hooberman/prototype/Documentation/BoardConfig.pptx

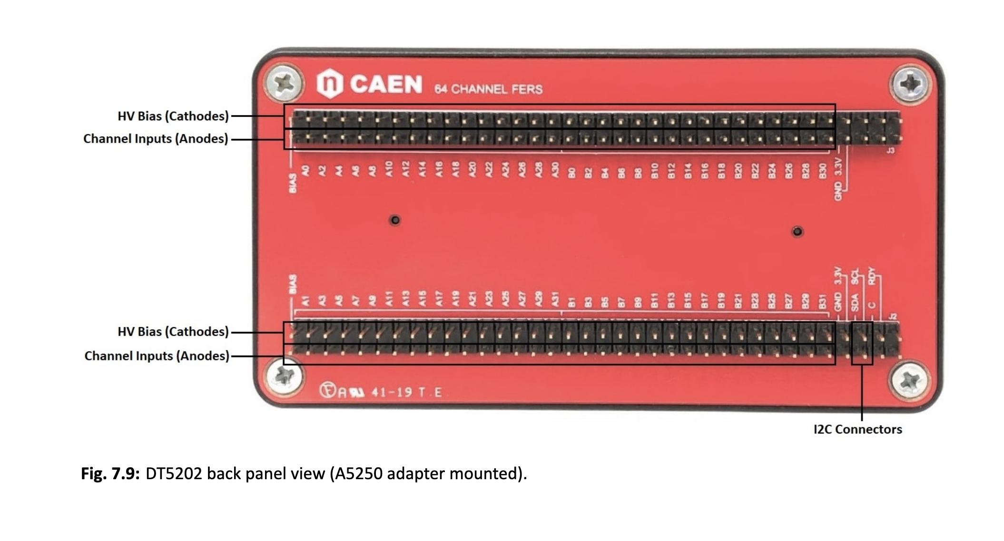
[picture p1: figure]
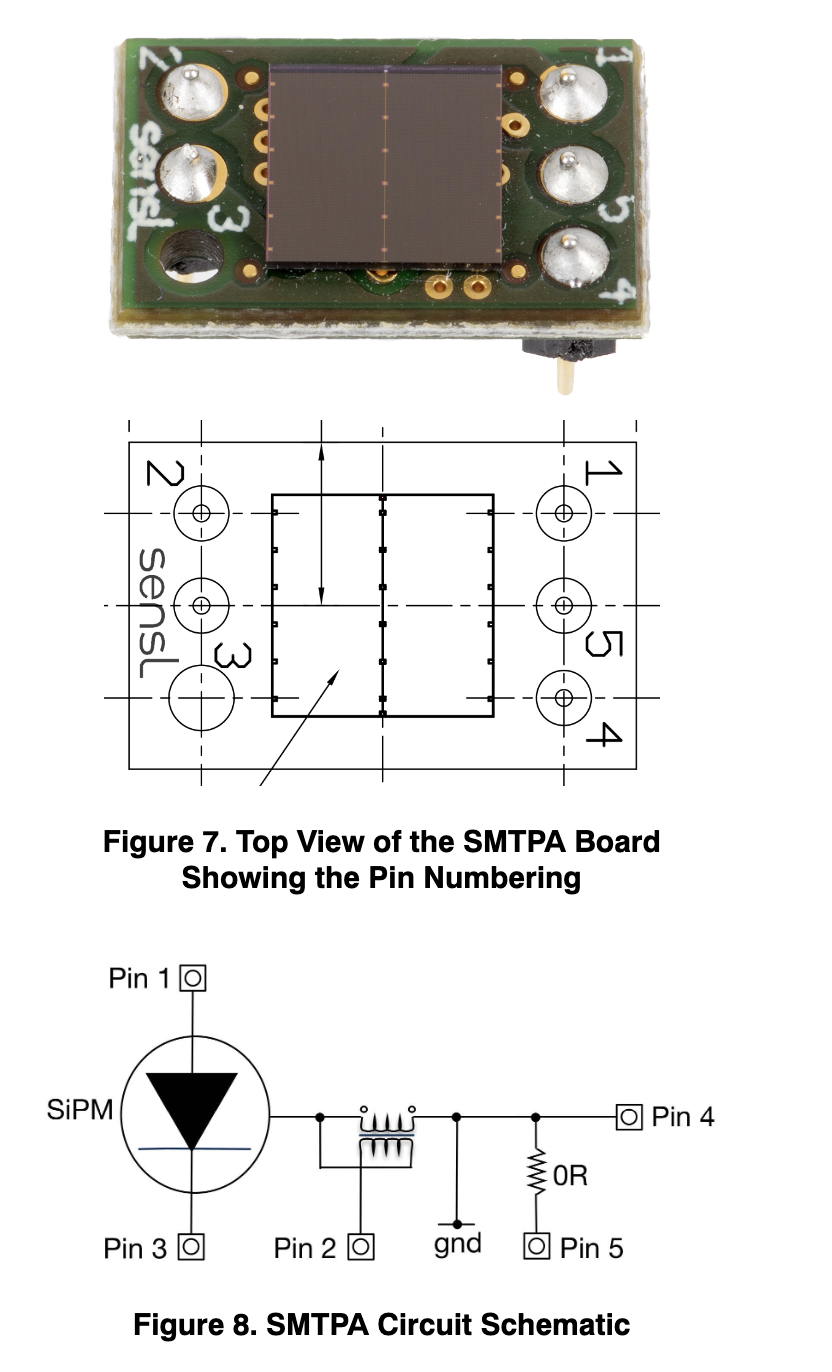
[picture p2: figure]
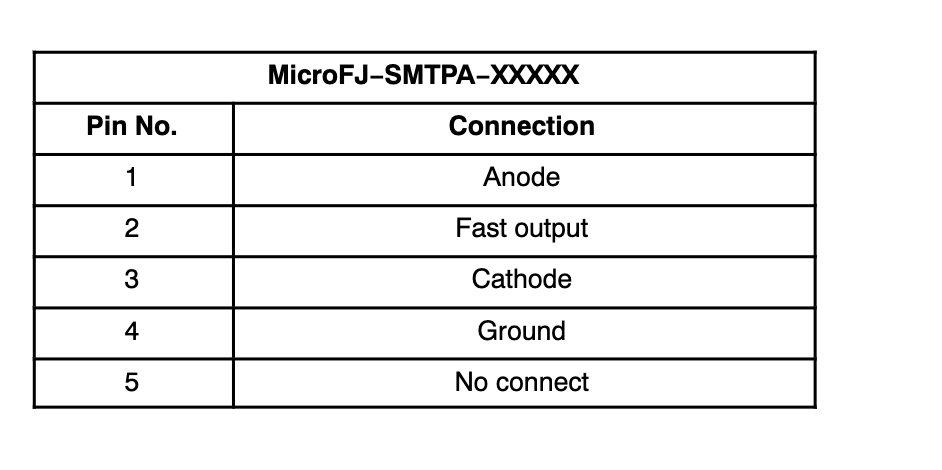
[picture p3: figure]
