hooberman/prototype/Electronics/board_preview_connector_labeled.png

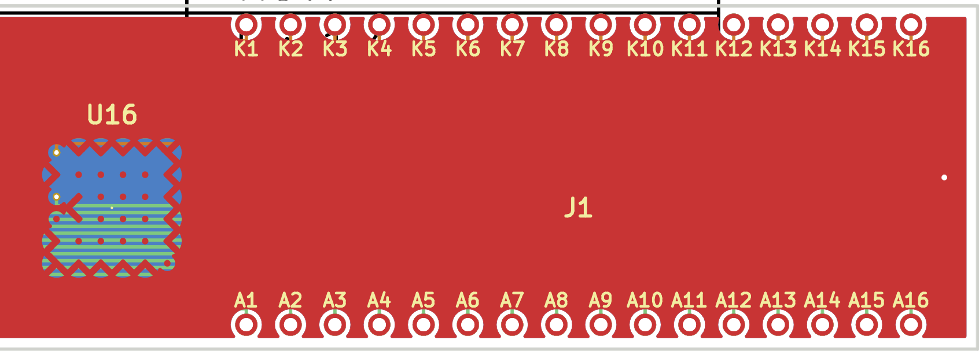
Electronics/board_preview_connector_labeled.png
