hooberman/prototype/Electronics/sipm_array_16ch_1.kicad_pcb

## KiCad design Electronics/sipm_array_16ch_1.kicad_pcb (2026-07-02)

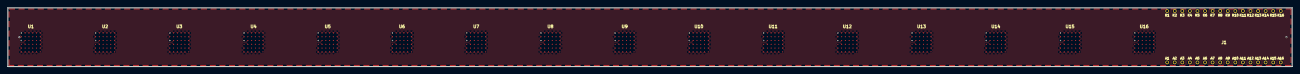
[picture p10: board sipm_array_16ch_1.kicad_pcb from above]

Board: 4 copper layers, 339.1 x 15.5 mm, 17 parts (0 on the bottom side), 33 nets.

Parts:
J1: (no value)
U1, U2, U3, U4, U5, U6, U7, U8, U9, U10, U11, U12, U13, U14, U15, U16: (no value)

Connections:
Anode1: J1.A1, U1.C1, U1.D1
Anode2: J1.A2, U2.C1, U2.D1
Anode3: J1.A3, U3.C1, U3.D1
Anode4: J1.A4, U4.C1, U4.D1
Anode5: J1.A5, U5.C1, U5.D1
Anode6: J1.A6, U6.C1, U6.D1
Anode7: J1.A7, U7.C1, U7.D1
Anode8: J1.A8, U8.C1, U8.D1
Anode9: J1.A9, U9.C1, U9.D1
Anode10: J1.A10, U10.C1, U10.D1
Anode11: J1.A11, U11.C1, U11.D1
Anode12: J1.A12, U12.C1, U12.D1
Anode13: J1.A13, U13.C1, U13.D1
Anode14: J1.A14, U14.C1, U14.D1
Anode15: J1.A15, U15.C1, U15.D1
Anode16: J1.A16, U16.C1, U16.D1
Cathode1: J1.K1, U1.A1, U1.F6
Cathode2: J1.K2, U2.A1, U2.F6
Cathode3: J1.K3, U3.A1, U3.F6
Cathode4: J1.K4, U4.A1, U4.F6
Cathode5: J1.K5, U5.A1, U5.F6
Cathode6: J1.K6, U6.A1, U6.F6
Cathode7: J1.K7, U7.A1, U7.F6
Cathode8: J1.K8, U8.A1, U8.F6
Cathode9: J1.K9, U9.A1, U9.F6
Cathode10: J1.K10, U10.A1, U10.F6
Cathode11: J1.K11, U11.A1, U11.F6
Cathode12: J1.K12, U12.A1, U12.F6
Cathode13: J1.K13, U13.A1, U13.F6
Cathode14: J1.K14, U14.A1, U14.F6
Cathode15: J1.K15, U15.A1, U15.F6
Cathode16: J1.K16, U16.A1, U16.F6
GND: U1.A2, U1.A3, U1.A4, U1.A5, U1.A6, U1.B1, U1.B2, U1.B3, U1.B4, U1.B5, U1.B6, U1.C2, U1.C3, U1.C4, U1.C5, U1.C6, U1.D2, U1.D3, U1.D4, U1.D5, U1.D6, U1.E1, U1.E2, U1.E3, U1.E4, U1.E5, U1.E6, U1.F1, U1.F2, U1.F3, U1.F4, U1.F5, U2.A2, U2.A3, U2.A4, U2.A5, U2.A6, U2.B1, U2.B2, U2.B3, U2.B4, U2.B5, U2.B6, U2.C2, U2.C3, U2.C4, U2.C5, U2.C6, U2.D2, U2.D3, U2.D4, U2.D5, U2.D6, U2.E1, U2.E2, U2.E3, U2.E4, U2.E5, U2.E6, U2.F1, U2.F2, U2.F3, U2.F4, U2.F5, U3.A2, U3.A3, U3.A4, U3.A5, U3.A6, U3.B1, U3.B2, U3.B3, U3.B4, U3.B5, U3.B6, U3.C2, U3.C3, U3.C4, U3.C5, U3.C6, U3.D2, U3.D3, U3.D4, U3.D5, U3.D6, U3.E1, U3.E2, U3.E3, U3.E4, U3.E5, U3.E6, U3.F1, U3.F2, U3.F3, U3.F4, U3.F5, U4.A2, U4.A3, U4.A4, U4.A5, U4.A6, U4.B1, U4.B2, U4.B3, U4.B4, U4.B5, U4.B6, U4.C2, U4.C3, U4.C4, U4.C5, U4.C6, U4.D2, U4.D3, U4.D4, U4.D5, U4.D6, U4.E1, U4.E2, U4.E3, U4.E4, U4.E5, U4.E6, U4.F1, U4.F2, U4.F3, U4.F4, U4.F5, U5.A2, U5.A3, U5.A4, U5.A5, U5.A6, U5.B1, U5.B2, U5.B3, U5.B4, U5.B5, U5.B6, U5.C2, U5.C3, U5.C4, U5.C5, U5.C6, U5.D2, U5.D3, U5.D4, U5.D5, U5.D6, U5.E1, U5.E2, U5.E3, U5.E4, U5.E5, U5.E6, U5.F1, U5.F2, U5.F3, U5.F4, U5.F5, U6.A2, U6.A3, U6.A4, U6.A5, U6.A6, U6.B1, U6.B2, U6.B3, U6.B4, U6.B5, U6.B6, U6.C2, U6.C3, U6.C4, U6.C5, U6.C6, U6.D2, U6.D3, U6.D4, U6.D5, U6.D6, U6.E1, U6.E2, U6.E3, U6.E4, U6.E5, U6.E6, U6.F1, U6.F2, U6.F3, U6.F4, U6.F5, U7.A2, U7.A3, U7.A4, U7.A5, U7.A6, U7.B1, U7.B2, U7.B3, U7.B4, U7.B5, U7.B6, U7.C2, U7.C3, U7.C4, U7.C5, U7.C6, U7.D2, U7.D3, U7.D4, U7.D5, U7.D6, U7.E1, U7.E2, U7.E3, U7.E4, U7.E5, U7.E6, U7.F1, U7.F2, U7.F3, U7.F4, U7.F5, U8.A2, U8.A3, U8.A4, U8.A5, U8.A6, U8.B1, U8.B2, U8.B3, U8.B4, U8.B5, U8.B6, U8.C2, U8.C3, U8.C4, U8.C5, U8.C6, U8.D2, U8.D3, U8.D4, U8.D5, U8.D6, U8.E1, U8.E2, U8.E3, U8.E4, U8.E5, U8.E6, U8.F1, U8.F2, U8.F3, U8.F4, U8.F5, U9.A2, U9.A3, U9.A4, U9.A5, U9.A6, U9.B1, U9.B2, U9.B3, U9.B4, U9.B5, U9.B6, U9.C2, U9.C3, U9.C4, U9.C5, U9.C6, U9.D2, U9.D3, U9.D4, U9.D5, U9.D6, U9.E1, U9.E2, U9.E3, U9.E4, U9.E5, U9.E6, U9.F1, U9.F2, U9.F3, U9.F4, U9.F5, U10.A2, U10.A3, U10.A4, U10.A5, U10.A6, U10.B1, U10.B2, U10.B3, U10.B4, U10.B5, U10.B6, U10.C2, U10.C3, U10.C4, U10.C5, U10.C6, U10.D2, U10.D3, U10.D4, U10.D5, U10.D6, U10.E1, U10.E2, U10.E3, U10.E4, U10.E5, U10.E6, U10.F1, U10.F2, U10.F3, U10.F4, U10.F5, U11.A2, U11.A3, U11.A4, U11.A5, U11.A6, U11.B1, U11.B2, U11.B3, U11.B4, U11.B5, U11.B6, U11.C2, U11.C3, U11.C4, U11.C5, U11.C6, U11.D2, U11.D3, U11.D4, U11.D5, U11.D6, U11.E1, U11.E2, U11.E3, U11.E4, U11.E5, U11.E6, U11.F1, U11.F2, U11.F3, U11.F4, U11.F5, U12.A2, U12.A3, U12.A4, U12.A5, U12.A6, U12.B1, U12.B2, U12.B3, U12.B4, U12.B5, U12.B6, U12.C2, U12.C3, U12.C4, U12.C5, U12.C6, U12.D2, U12.D3, U12.D4, U12.D5, U12.D6, U12.E1, U12.E2, U12.E3, U12.E4, U12.E5, U12.E6, U12.F1, U12.F2, U12.F3, U12.F4, U12.F5, U13.A2, U13.A3, U13.A4, U13.A5, U13.A6, U13.B1, U13.B2, U13.B3, U13.B4, U13.B5, U13.B6, U13.C2, U13.C3, U13.C4, U13.C5, U13.C6, U13.D2, U13.D3, U13.D4, U13.D5, U13.D6, U13.E1, U13.E2, U13.E3, U13.E4, U13.E5, U13.E6, U13.F1, U13.F2, U13.F3, U13.F4, U13.F5, U14.A2, U14.A3, U14.A4, U14.A5, U14.A6, U14.B1, U14.B2, U14.B3, U14.B4, U14.B5, U14.B6, U14.C2, U14.C3, U14.C4, U14.C5, U14.C6, U14.D2, U14.D3, U14.D4, U14.D5, U14.D6, U14.E1, U14.E2, U14.E3, U14.E4, U14.E5, U14.E6, U14.F1, U14.F2, U14.F3, U14.F4, U14.F5, U15.A2, U15.A3, U15.A4, U15.A5, U15.A6, U15.B1, U15.B2, U15.B3, U15.B4, U15.B5, U15.B6, U15.C2, U15.C3, U15.C4, U15.C5, U15.C6, U15.D2, U15.D3, U15.D4, U15.D5, U15.D6, U15.E1, U15.E2, U15.E3, U15.E4, U15.E5, U15.E6, U15.F1, U15.F2, U15.F3, U15.F4, U15.F5, U16.A2, U16.A3, U16.A4, U16.A5, U16.A6, U16.B1, U16.B2, U16.B3, U16.B4, U16.B5, U16.B6, U16.C2, U16.C3, U16.C4, U16.C5, U16.C6, U16.D2, U16.D3, U16.D4, U16.D5, U16.D6, U16.E1, U16.E2, U16.E3, U16.E4, U16.E5, U16.E6, U16.F1, U16.F2, U16.F3, U16.F4, U16.F5
