hooberman/prototype/(commit log)

2026-09-15 tighten trigger to require all 4 channels
    [convertDataFile.py]
2026-09-15 tighten trigger
2026-09-15 fix phi convention, shift track in z
    [eventDisplay3D.py]
2026-09-16 add print option, fix ghosting
    [eventDisplay3D.py]
2026-09-17 add per-sipm calibration
2026-10-01 run on different model types with runtime parameter, apply theta max cut to phi distribution
